easilok/hidroponics-board/controller/BOM_Priced.ods

Qty | Reference(s) | Value | Price (un) | Price (total) | Model | Datasheet | Obs | LibPart | Footprint
2 | C2, C3 | 0.1u | 0.0405 € | 0.0810 € | CE-1/100P | https://www.tme.eu/en/details/ce-1_100p/85degc-tht-electrolytic-capacitors/samwha/sd2a105m05011bb159/ | Example for 1u From TME | Device:CP | Capacitor_THT:CP_Radial_D5.0mm_P2.00mm
2 | C5, C6 | 0.33u | 0.0166 € | 0.0332 € | CL21B334KBFNNNE | https://www.tme.eu/pt/details/cl21b334kbfnnne/capacitores-mlcc-smd-0805/samsung/ |  | Device:C | Capacitor_SMD:C_0805_2012Metric
1 | C8 | 0.1u | 0.0168 € | 0.0168 € | VJ0805Y104KXACW1BC | https://www.tme.eu/pt/details/vj0805y104kxacw1bc/capacitores-mlcc-smd-0805/vishay/ |  | Device:C | Capacitor_SMD:C_0805_2012Metric
2 | D1, D2 | LED | 0.0111 € | 0.0222 € | Ebay | https://www.ebay.co.uk/itm/223444008196?var=522199322564 |  | Device:LED | LED_THT:LED_D3.0mm
2 | D3, D4 | D | 0.0322 € | 0.0644 € | SR280-YAN | https://www.tme.eu/pt/details/sr280-yan/diodos-schottky-tht/yangjie-technology/sr280/ |  | Device:D | Diode_THT:D_DO-41_SOD81_P7.62mm_Horizontal
1 | D5 | D_Zener_x2_ACom_AKK | 0.0690 € | 0.0690 € | AZ23C4V7-7-F | https://www.tme.eu/en/details/az23c4v7-7-f/smd-zener-diodes/diodes-incorporated/ | Borrow From NIBBLE | Device:D_Zener_x2_ACom_KKA | Package_TO_SOT_SMD:SOT-23
1 | J1 | QRSwitch | 0.1375 € | 0.1375 € | Ebay | https://www.ebay.co.uk/itm/133453552787?var=432889210476 |  | Connector:Screw_Terminal_01x02 | TerminalBlock:TerminalBlock_bornier-2_P5.08mm
1 | J2 | Screen | 0.2750 € | 0.2750 € | Ebay | https://www.ebay.co.uk/itm/133453552787?var=432889210476 |  | Connector:Screw_Terminal_01x04 | TerminalBlock:TerminalBlock_bornier-4_P5.08mm
1 | J3 | Irrigation | 0.1375 € | 0.2750 € | Ebay | https://www.ebay.co.uk/itm/172541810975?var=471393167688 |  | Connector:Screw_Terminal_01x03 | TerminalBlock:TerminalBlock_bornier-3_P5.08mm
1 | J4 | EnvSensor | 0.2750 € | 0.2750 € | Ebay | https://www.ebay.co.uk/itm/133453552787?var=432889210476 |  | Connector:Screw_Terminal_01x04 | TerminalBlock:TerminalBlock_bornier-4_P5.08mm
1 | J5 | Power | 0.1375 € | 0.1375 € | Ebay | https://www.ebay.co.uk/itm/133453552787?var=432889210476 |  | Connector:Screw_Terminal_01x02 | TerminalBlock:TerminalBlock_bornier-2_P5.08mm
1 | J6 | PumpRelay | 0.1375 € | 0.1375 € | Ebay | https://www.ebay.co.uk/itm/172541810975?var=471393167688 |  | Connector:Screw_Terminal_01x03 | TerminalBlock:TerminalBlock_bornier-3_P5.08mm
1 | J7 | Condutivity | 0.1375 € | 0.1375 € | Ebay | https://www.ebay.co.uk/itm/172541810975?var=471393167688 |  | Connector:Screw_Terminal_01x03 | TerminalBlock:TerminalBlock_bornier-3_P5.08mm
1 | Q1 | Q_NPN_BCE | 0.0322 € | 0.0322 € | MPS2222-CDI | https://www.tme.eu/pt/details/mps2222-cdi/transistores-npn-tht/cdil/mps2222/ |  | Device:Q_NPN_BCE | Package_TO_SOT_THT:TO-92
2 | R1, R2 | 10K | 0.0141 € | 0.0282 € | SMD0805-10K-1% | https://www.tme.eu/pt/details/smd0805-10k-1%25/resistencias-smd-0805/royal-ohm/0805s8f1002t5e/ |  | Device:R | Resistor_SMD:R_0805_2012Metric
3 | R3, R4, R5 | 0 | 0.0000 € | 0.0000 € | Nothing used, just to split |  |  | Device:R | Resistor_SMD:R_0805_2012Metric
2 | R6, R7 | 1K | 0.0139 € | 0.0278 € | RC0805FR-071K | https://www.tme.eu/pt/details/rc0805fr-071k/resistencias-smd-0805/yageo/rc0805fr-071kl/ |  | Device:R | Resistor_SMD:R_0805_2012Metric
1 | RLY1 | AZ943-1CH-12DE | 0.4400 € | 0.4400 € | AZ943-1CH-12DE | https://www.tme.eu/pt/details/az943-1ch-12de/reles-eletromagnetico-em-miniatura/zettler/ |  | dk_Automotive-Relays:JSM1-12V-5 | LCP_Footprints:Relay_SPDT_ZETTLER_AZ943_Series_Form_C
0 | U1 | WeMos_D1_mini | 4.9500 € | 0.0000 € | Ebay | https://www.ebay.co.uk/itm/254535886946 | Set quantity if using this one | MCU_Module:WeMos_D1_mini | Module:WEMOS_D1_mini_light
1 | U2 | NodeMCU_ESP12E | 5.4500 € | 5.4500 € | Ebay | https://www.ebay.co.uk/itm/293729116358 | Set quantity if using this one | LCP_MCU_Module:NodeMCU_ESP12E | LCP_Footprints:NodeMCU1.0_12-E
1 | U3 | LM7805_TO220 | 0.2438 € | 0.2438 € | Old – LM7805-CDI | https://www.tme.eu/en/details/lm7805-cdi/unregulated-voltage-regulators/cdil/lm7805/ | Price based on TME equivalent | Regulator_Linear:LM7805_TO220 | Package_TO_SOT_THT:TO-220-3_Vertical
1 | U4 | LM7809_TO220 | 0.2400 € | 0.2400 € | Old – L7809CV | https://www.tme.eu/en/details/l7809cv/unregulated-voltage-regulators/stmicroelectronics/ | Price based on TME equivalent | Regulator_Linear:LM7809_TO220 | Package_TO_SOT_THT:TO-220-3_Vertical
1 | - | Power Supply | 7.0000 € | 7.0000 € | Meanwell – RS-15-12 | https://www.tme.eu/pt/details/rs-15-12/fontes-de-alimentacao-tipo-built-in/mean-well/
1 | - | PCB | 3.0400 € | 3.0400 € | JLCPCB | https://jlcpcb.com/
1 | - | BOX | 0.7000 € | 0.7000 € | Tupperware
1 |  | QRSwitch (Push Button) | 1.0460 € | 1.0460 € | Ebay | https://www.ebay.co.uk/itm/261161661277?var=560382974005 https://www.ebay.co.uk/itm/293553763783?var=592363654733
0 |  | WeMos_D1_mini (Headers) | 0.1750 € | 0.0000 € | Ebay | https://www.ebay.co.uk/itm/264236708069?var=564637007508 | Set quantity if using this one
2 |  | NodeMCU_ESP12E (Headers) | 0.1750 € | 0.3500 € | Ebay | https://www.ebay.co.uk/itm/264236708069?var=564648418654 | Set quantity if using this one
1 | - | Mains Power Connector | 0.6437 € | 0.6437 € | IEC-A-2 | https://www.tme.eu/pt/details/iec-a-2/conectores-iec-60320/adam-tech/
1 |  | OLED Screen | 3.2300 € | 3.2300 € | Ebay | https://www.ebay.co.uk/itm/112934969503?var=413321092554
1 |  | Condutivity Sensor | 11.7400 € | 11.7400 € | Ebay | https://www.ebay.co.uk/itm/203137647670
1 |  | Water Pump (8W) | 9.4200 € | 9.4200 € | Ebay | https://www.ebay.co.uk/itm/313344756592?var=612225400641
1 |  | BME280 Environment Sensor | 2.6000 € | 2.6000 € | Ebay | £2.23
Total Eletronics: |  |  |  | 20.90 € | Total | 47.89 €
