easilok/hidroponics-board/controller/controller_schematic.pdf

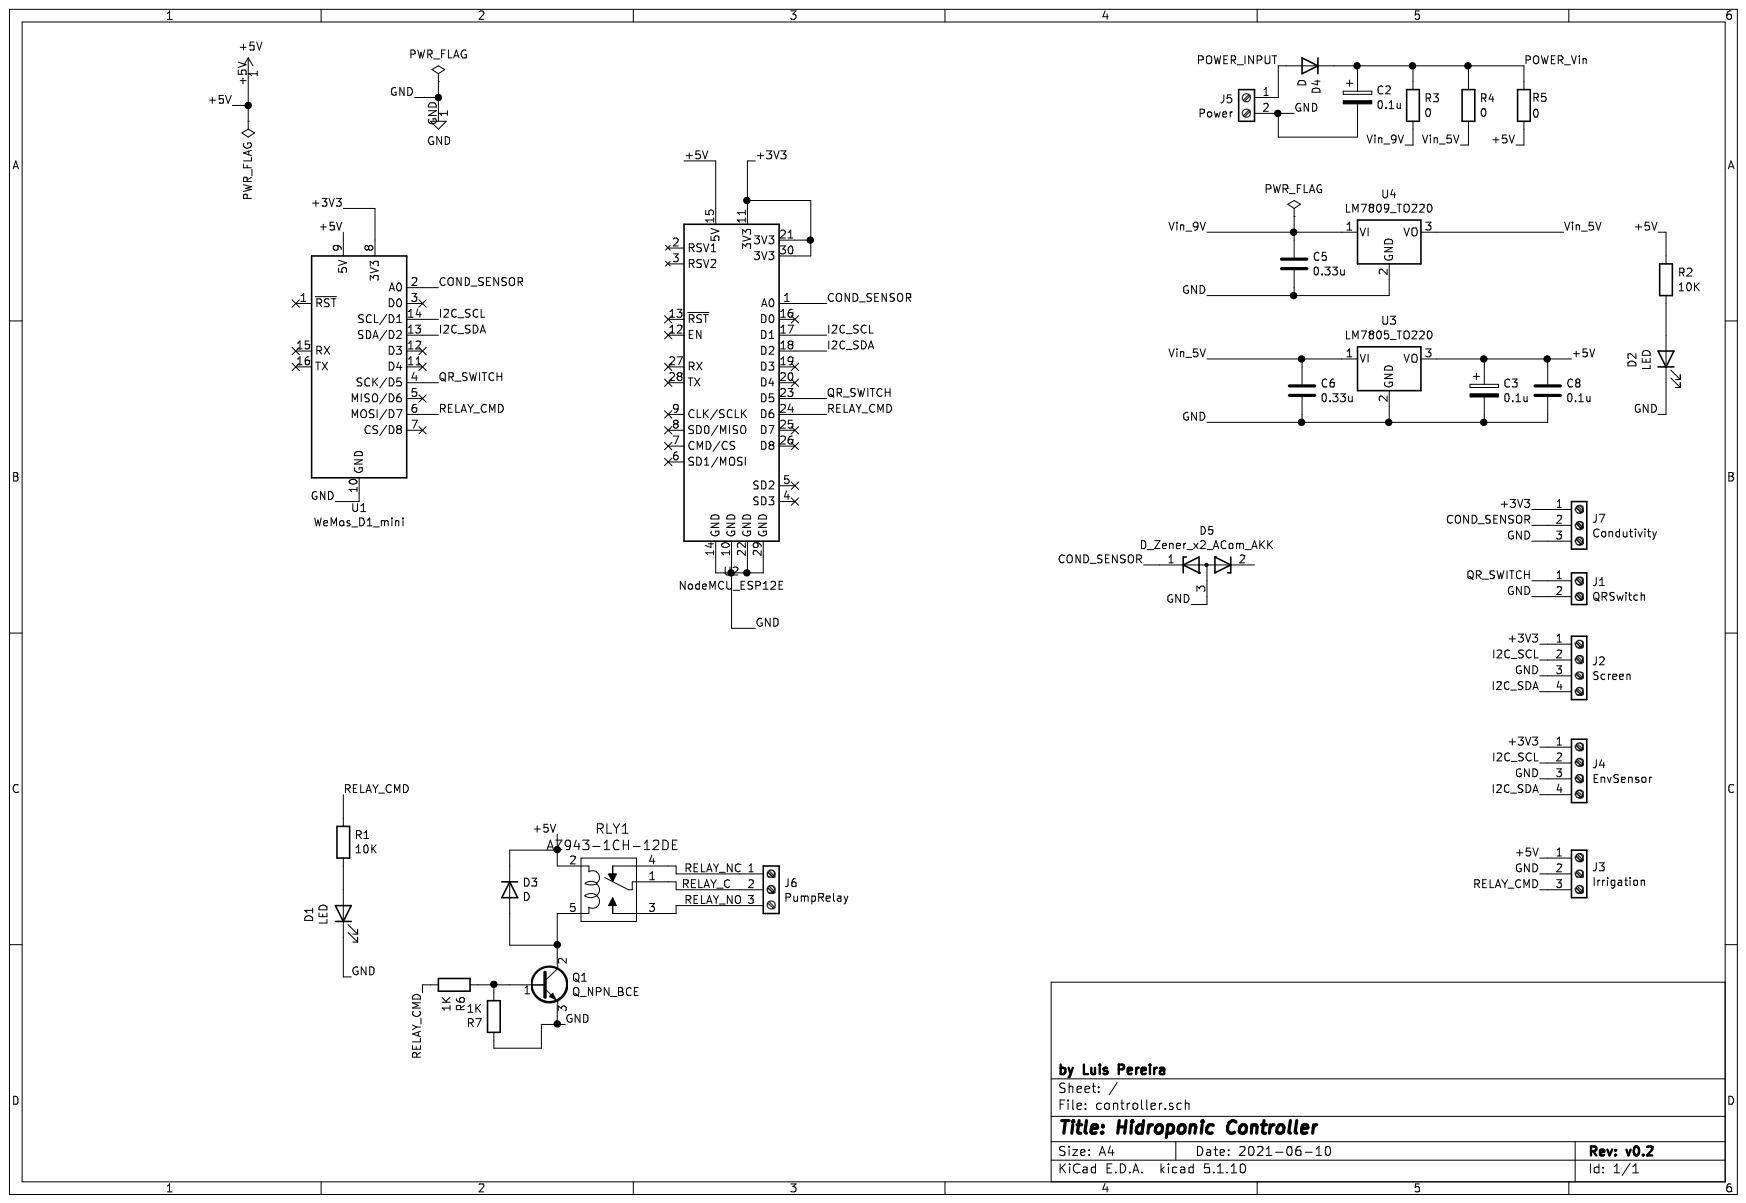
[picture p1: page 1]
