easilok/hidroponics-board/controller/controller_pcb.pdf

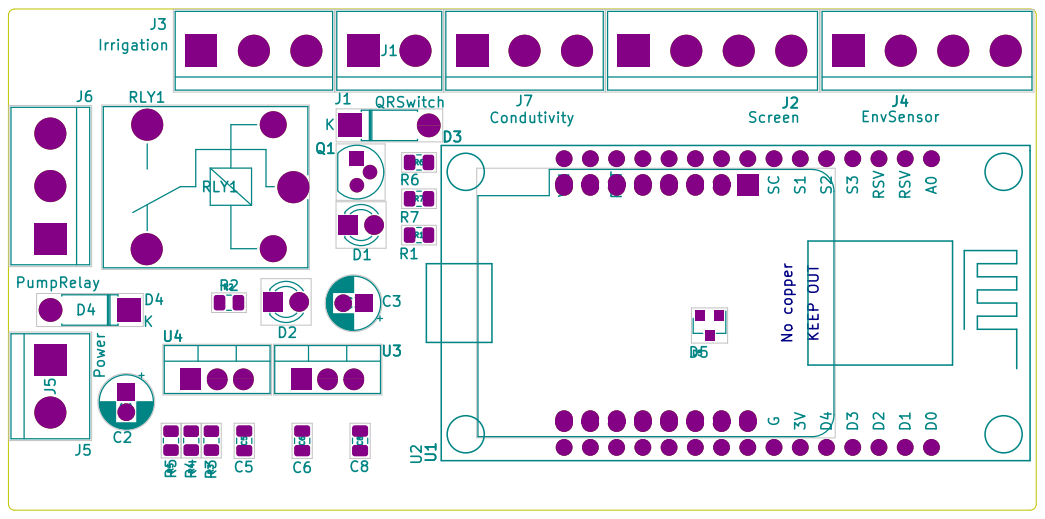
[picture p2: page 1]
