easilok/hidroponics-board/controller/controller_v0_3.kicad_pcb

## KiCad design controller/controller_v0_3.kicad_pcb (2022-04-29)

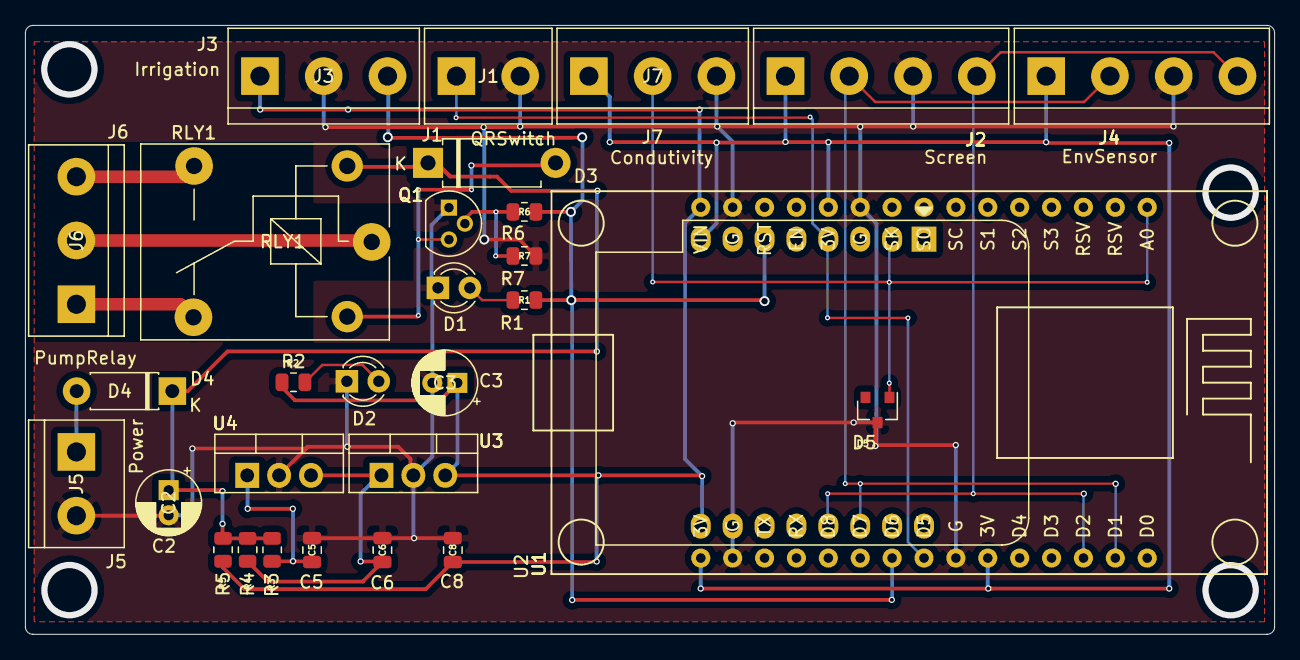
[picture p3: board controller_v0_3.kicad_pcb from above]

Board: 2 copper layers, 99.5 x 48.5 mm, 30 parts (0 on the bottom side), 19 nets.

Parts:
C2, C3: 0.1u; CP_Radial_D5.0mm_P2.00mm
C5, C6: 0.33u; C_0805_2012Metric
C8: 0.1u; C_0805_2012Metric
D1, D2: LED; LED_D3.0mm
D3: D; D_DO-15_P10.16mm_Horizontal
D4: D; D_DO-41_SOD81_P7.62mm_Horizontal
D5: D_Zener_x2_ACom_AKK; SOT-23
J1: QRSwitch; TerminalBlock_bornier-2_P5.08mm
J2: Screen; TerminalBlock_bornier-4_P5.08mm
J3: Irrigation; TerminalBlock_bornier-3_P5.08mm
J4: EnvSensor; TerminalBlock_bornier-4_P5.08mm
J5: Power; TerminalBlock_bornier-2_P5.08mm
J6: PumpRelay; TerminalBlock_bornier-3_P5.08mm
J7: Condutivity; TerminalBlock_bornier-3_P5.08mm
Q1: MPS2222; TO-92
R1, R2: 10K; R_0805_2012Metric
R3, R4, R5: 0; R_0805_2012Metric
R6, R7: 1K; R_0805_2012Metric
RLY1: AZ943-1CH-12DE; Relay_SPDT_ZETTLER_AZ943_Series_Form_C
U1: WeMos_D1_mini; WEMOS_D1_mini_light
U2: NodeMCU_ESP12E; NodeMCU1.0_12-E
U3: LM7805_TO220; TO-220-3_Vertical
U4: LM7809_TO220; TO-220-3_Vertical

Connections:
+5V: C3.1, C8.1, J3.1, R2.1, R5.2, U1.9, U2.15, U3.3
/+3V3: J2.1, J4.1, J7.1, U1.8, U2.11, U2.16, U2.25
/COND_SENSOR: D5.1, J7.2, U1.2, U2.1
/I2C_SCL: J2.2, J4.2, U1.14, U2.29
/I2C_SDA: J2.4, J4.4, U1.13, U2.28
/POWER_INPUT: D4.2, J5.1
/POWER_Vin: C2.1, D3.1, D4.1, R3.1, R4.1, R5.1, RLY1.2
/QR_SWITCH: J1.1, U1.4, U2.23
/RELAY_C: J6.2, RLY1.1
/RELAY_CMD: J3.3, R1.1, R6.2, U1.6, U2.22
/RELAY_NC: J6.1, RLY1.4
/RELAY_NO: J6.3, RLY1.3
/Vin_5V: C6.1, R4.2, U3.1, U4.3
/Vin_9V: C5.1, R3.2, U4.1
GND: C2.2, C3.2, C5.2, C6.2, C8.2, D1.1, D2.1, D5.3, J1.2, J2.3, J3.2, J4.3, J5.2, J7.3, Q1.1, R7.1, U1.10, U2.10, U2.14, U2.17, U2.24, U3.2, U4.2
unnamed: D1.2, R1.2
unnamed: D2.2, R2.2
unnamed: D3.2, Q1.3, RLY1.5
unnamed: Q1.2, R6.1, R7.2
