easilok/hidroponics-board/(commit log)

2021-06-04 Wemos D1 implemented
    [controller.kicad_pcb, controller.sch]
2021-06-17 Released to production V0.2
    [controller-B_Cu.gbl, controller-B_Mask.gbs, controller-B_Paste.gbp, controller-B_SilkS.gbo, controller-Edge_Cuts.gm1, controller-F_Cu.gtl, controller-F_Mask.gts, controller-F_Paste.gtp]
2021-06-18 Added BOM
    [BOM_Priced.ods, controller.csv]
2021-07-08 Production version. First iteration for correction
    [controller.sch, controller_v0_3.kicad_pcb, controller_v0_3.sch]
2022-04-29 Added version 0.3 with hardware corrections
    [controller_v0_3.kicad_pcb, controller_v0_3.kicad_sch]
